Gernreich/hex-dice-box/step/hex-dice-box.step

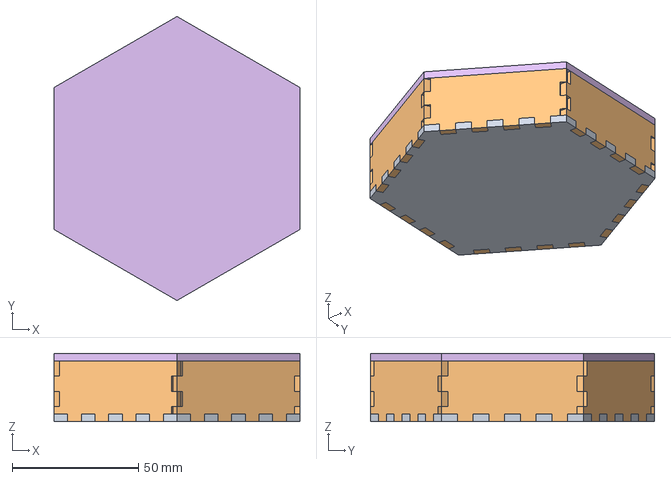
[picture p1: CAD file, 2026-11-10]
step/hex-dice-box.step
97.3 x 112.4 x 27.0 mm
