Gernreich/hex-dice-box/(commit log)

2026-10-18 Hexagonal dice box: finger-jointed box, seven-pocket inserts, magnet lid
    Generator for 3mm ply on the xTool P2S: six identical walls on a jointed
    floor, glued insert layers with seven hex pockets, and a plugged lid held
    by 2x1mm discs in rastered indents. One cut sheet, --kerf= option, 3D
    preview template, validation block.
2026-10-18 Keep the 3D page in the repo as index.html
    The preview lived only as a private claude.ai artifact. Every run now
    writes index.html, a standalone page with the 3D view, the cut sheet and
    the assembly, and the README points there instead.
2026-10-18 Publish the 3D page on GitHub Pages and link it from the README
    Same Actions workflow as the LaserMadeMusic repos: the tree is uploaded
    as-is, so index.html serves at gernreich.github.io/hex-dice-box/.
2026-10-18 3D view: Spread now opens the lid too
    The lid moved as one block, so the plug and the lid plate never came
    apart. Spread lifts the plate off the plug as it lifts each insert, and
    the lid's discs ride in the plug.
2026-10-18 3D view: frame the opened stack
    With the lid lifted and the layers spread the lid ran off the top of the
    view; the camera stands further off and looks at the middle of the stack.
2026-10-18 3D view: magnets show and come apart with the layers
    The discs were true-size and dull grey, so they hardly showed. They are
    bright now, and Spread lifts each box disc out of its indent and drops
    each lid disc out of the plug, a third of the gap each.
2026-10-18 3D view: draw the magnets 2.5x size
    At true size a 2mm disc on a 97mm box couldn't be seen. Drawn larger,
    flush with their faces, and labelled so in the key; spread moves each
    clear of its plate.
2026-10-18 3D view: magnets stand a little proud so they show at rest
    Drawn flush, a disc's face and the ply's lay in one plane and the ply
    hid it until Spread lifted it clear.
2026-10-19 turn.html: the 3D view alone, for the hub to frame
    Every run writes it beside index.html: the same page with the header,
    figures and sections hidden and the view filling the window.
2026-10-21 3D view: zoom toward the pointer, double-click a part to turn round it
    Scroll and pinch zoom about the point under the pointer, not the middle;
    double-click a part to orbit it, empty space to go back to the opening view.
    Panning was OrbitControls' already: right-drag, shift-drag, two fingers.
2026-10-21 Walls press-fit, not glued; × in dimensions; name the licence
2026-10-22 Drop the xTool P2S label; the box only needs a 600 x 305mm bed
2026-11-08 STEP file of the box, for a CAD program
    step/hex-dice-box.step, one solid body per plate, written from index.html
    by lasermade-tools step-export; documents-gates regenerates it.
    [hex-dice-box.step]
2026-11-08 Port the generator to Rust; the box as a parametric SolidCraft design
    hex_dice_box.rs replaces hex_dice_box.py: the sheet, index.html, turn.html
    and the report are byte-identical to the Python's at five flag sets. It
    builds alone (src/ holds copies of the LaserMadeMusic tools' Python-number
    helpers, random and script writer).
    --solidcraft=DIR writes solidcraft/hex-dice-box.solidcraft.json: 15 plates,
    every point an expression in ply, pocket, web, rim, fit, plug_fit, nip and
    the indents, checked against the generator's outlines before writing.
    SolidCraft builds hex-dice-box.sc and step/hex-dice-box.step from it; the old
    STEP file, written from the 3D view by step-export, is gone. The new one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
    [hex-dice-box.step]
2026-11-10 SolidCraft design: finger counts follow the sizes
    n_b (cells along a floor edge, odd) and n_v (up a wall's side, even) are
    floor() expressions of edge, box_h and a new finger parameter, as counts()
    works them out. The floor and walls are drawn plain and each row of cut
    cells is one cut patterned along its edge. At the defaults every body's
    volume is the old design's to 5e-11 mm3; with pocket 34 mm, ply 4.5 mm and
    both, the floor, walls and lid match the generator's to 1e-4 mm3.
    [hex-dice-box.step]
